vy038/Project_Stride/CAD/GBM2804H_Encoder_Joint_V2/GBM2804H Encoder Joint - Stationary Cap.stl

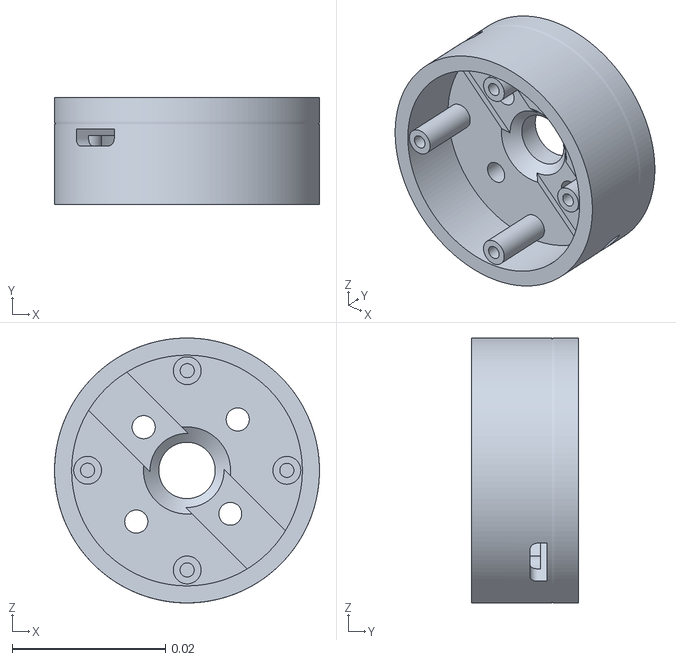
[picture p1: CAD file, 2026-08-30]
CAD/GBM2804H_Encoder_Joint_V2/GBM2804H Encoder Joint - Stationary Cap.stl
0.0346 x 0.014 x 0.0346
