vy038/Project_Stride/CAD/leg/leg - Stand.stl

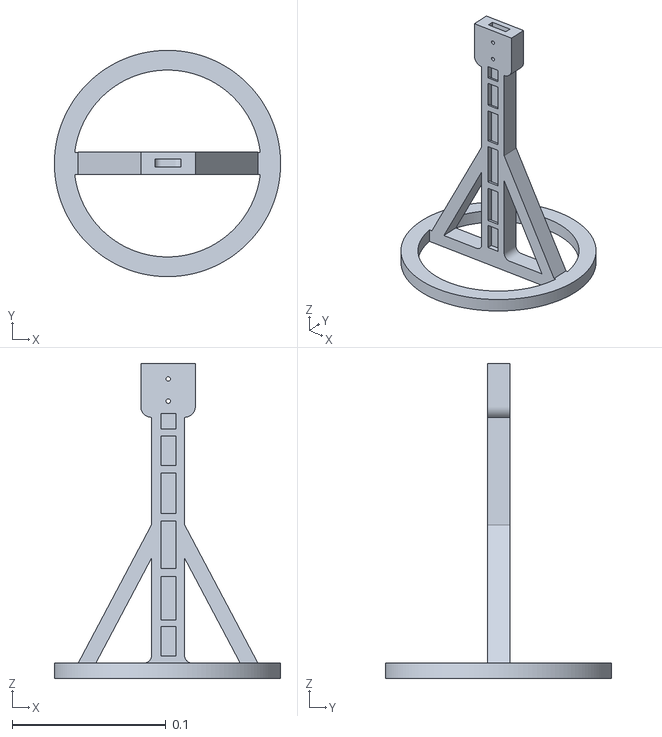
[picture p2: CAD file, 2026-08-30]
CAD/leg/leg - Stand.stl
0.147 x 0.147 x 0.205
