vy038/Project_Stride/CAD/GBM2804H_Encoder_Joint_V2/GBM2804H Encoder Joint - Magnetic Shaft.stl

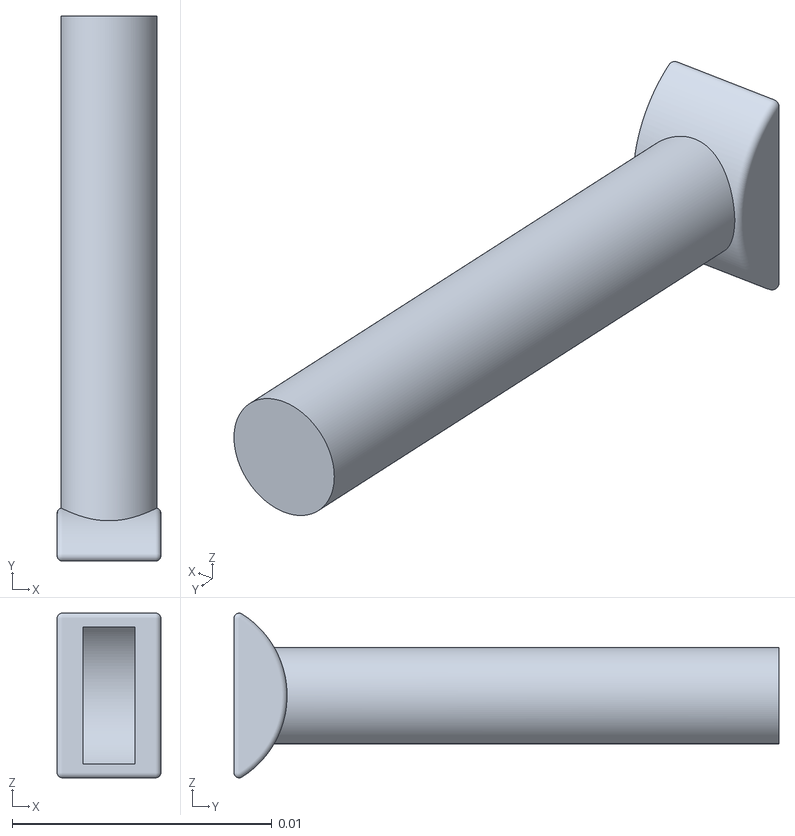
[picture p3: CAD file, 2026-08-30]
CAD/GBM2804H_Encoder_Joint_V2/GBM2804H Encoder Joint - Magnetic Shaft.stl
0.004 x 0.021 x 0.00635
