vy038/Project_Stride/CAD/leg/leg - Encoder Mount on Stationary Cap.stl

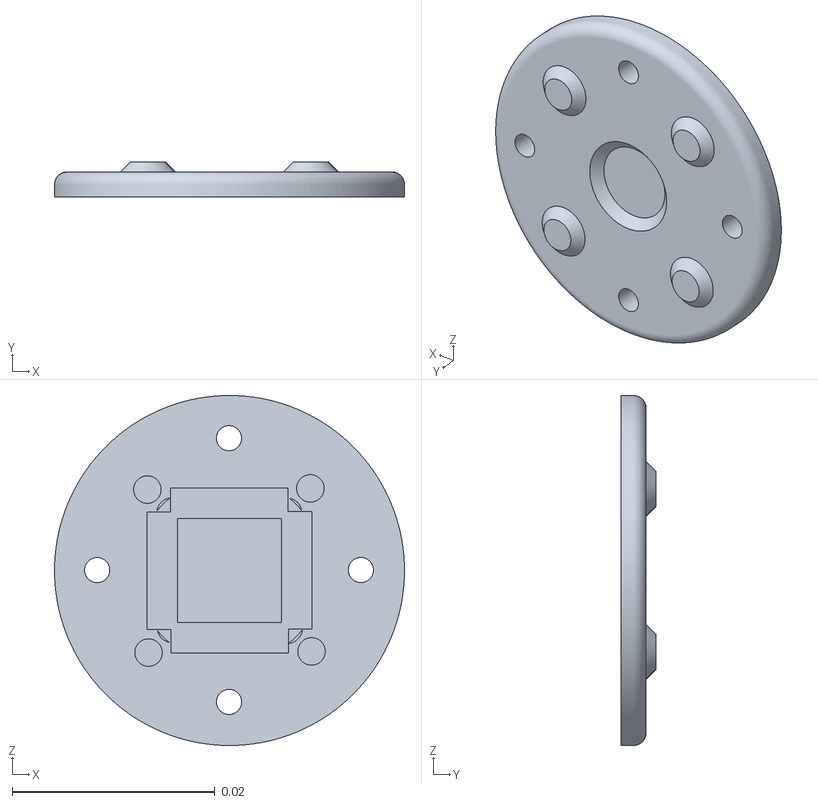
[picture p4: CAD file, 2026-08-30]
CAD/leg/leg - Encoder Mount on Stationary Cap.stl
0.0346 x 0.0035 x 0.0346
