vy038/Project_Stride/CAD/GBM2804H_Encoder_Joint_V2/GBM2804H Encoder Joint - Rotating Cap.stl

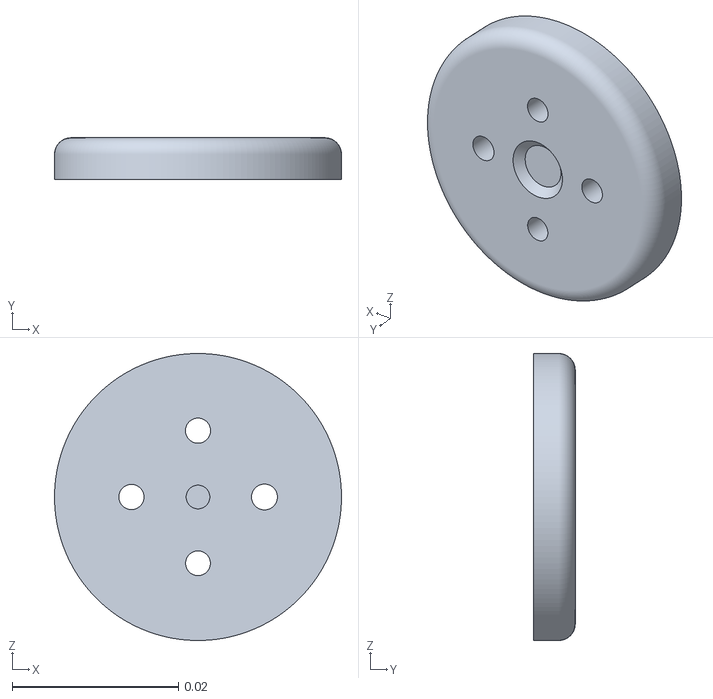
[picture p5: CAD file, 2026-08-30]
CAD/GBM2804H_Encoder_Joint_V2/GBM2804H Encoder Joint - Rotating Cap.stl
0.0346 x 0.005 x 0.0346
