vy038/Project_Stride/CAD/leg/leg - Hip.stl

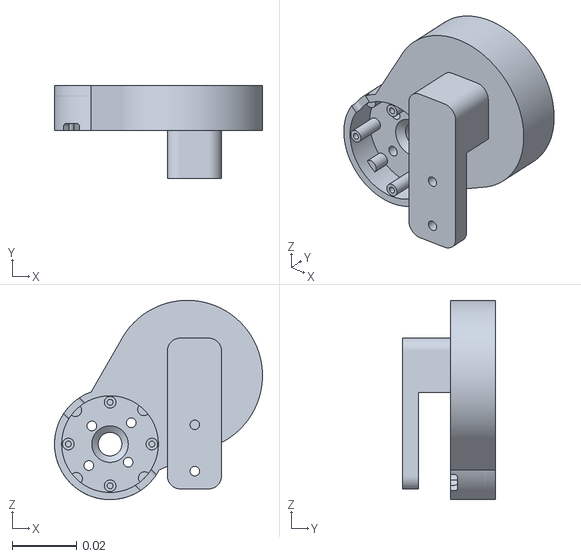
[picture p6: CAD file, 2026-08-30]
CAD/leg/leg - Hip.stl
0.0647 x 0.029 x 0.062
