vy038/Project_Stride/CAD/leg/leg - Tibia.stl

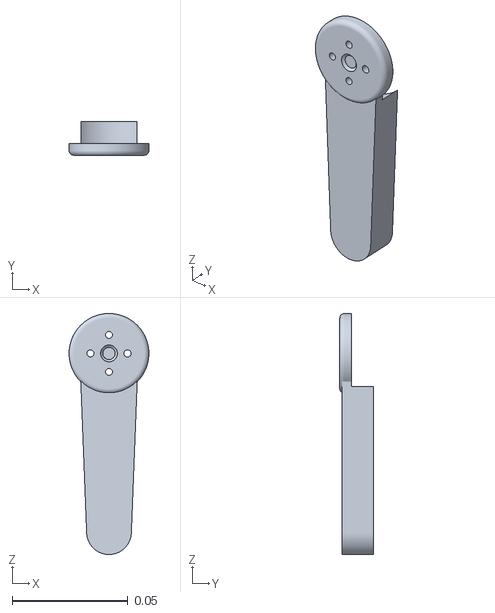
[picture p7: CAD file, 2026-08-30]
CAD/leg/leg - Tibia.stl
0.0346 x 0.0145 x 0.104
