vy038/Project_Stride/CAD/leg/leg - Femur.stl

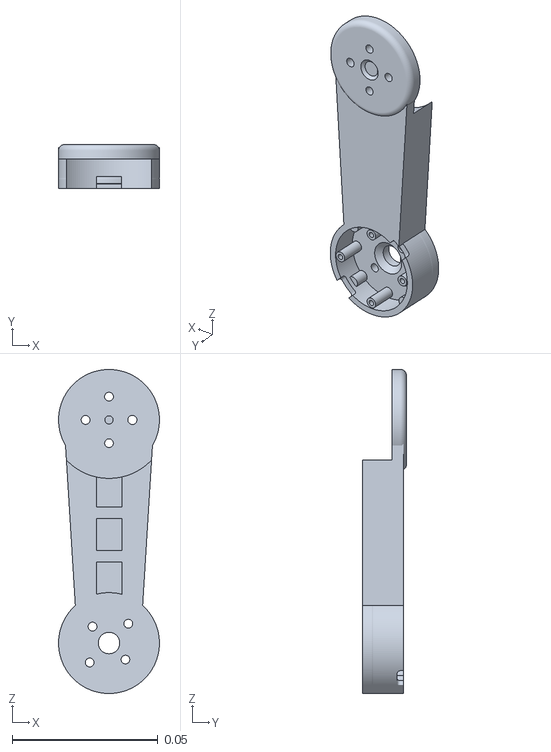
[picture p8: CAD file, 2026-08-30]
CAD/leg/leg - Femur.stl
0.0346 x 0.015 x 0.111
