vy038/Project_Stride/CAD/GBM2804H_Encoder_Joint_V1/Magnetic_Shaft.stl

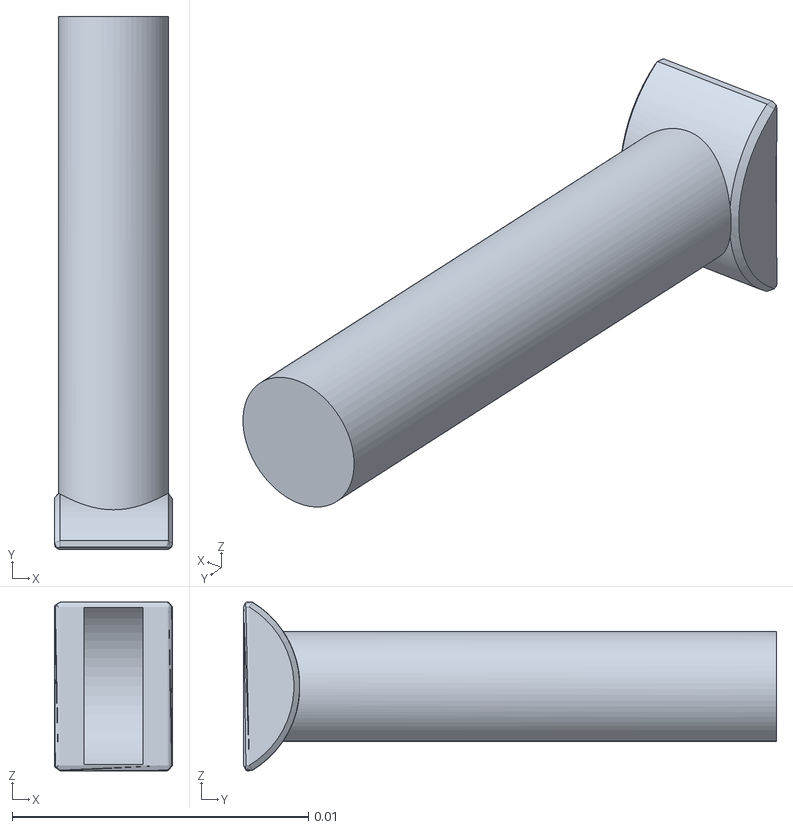
[picture p10: CAD file, 2026-06-14, an earlier design]
CAD/GBM2804H_Encoder_Joint_V1/Magnetic_Shaft.stl
0.004 x 0.018 x 0.00571
