vy038/Project_Stride/CAD/GBM2804H_Encoder_Joint_V1/Magnet.stl

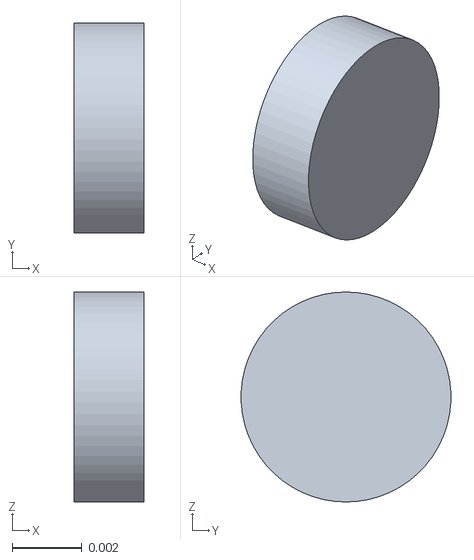
[picture p12: CAD file, 2026-06-14, an earlier design]
CAD/GBM2804H_Encoder_Joint_V1/Magnet.stl
0.002 x 0.006 x 0.006
