vy038/Project_Stride/CAD/GBM2804H_Encoder_Joint_V1/GBM2804H_Motor.stl

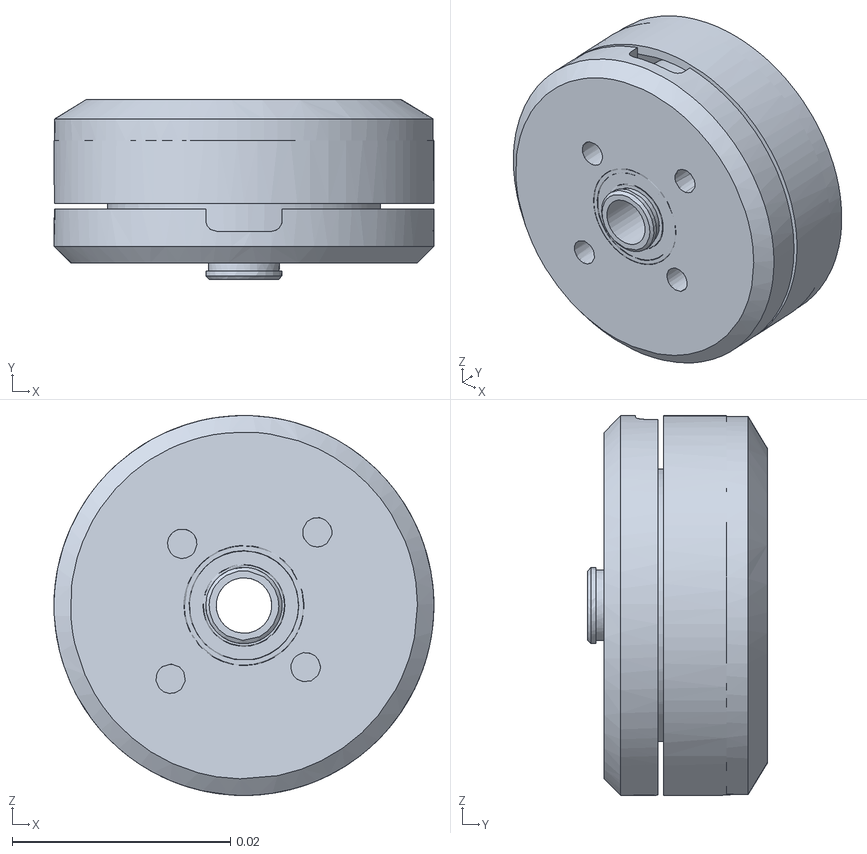
[picture p13: CAD file, 2026-06-14, an earlier design]
CAD/GBM2804H_Encoder_Joint_V1/GBM2804H_Motor.stl
0.0348 x 0.0164 x 0.0348
