vy038/Project_Stride/CAD/GBM2804H_Encoder_Joint_V1/Stationary_Cap.stl

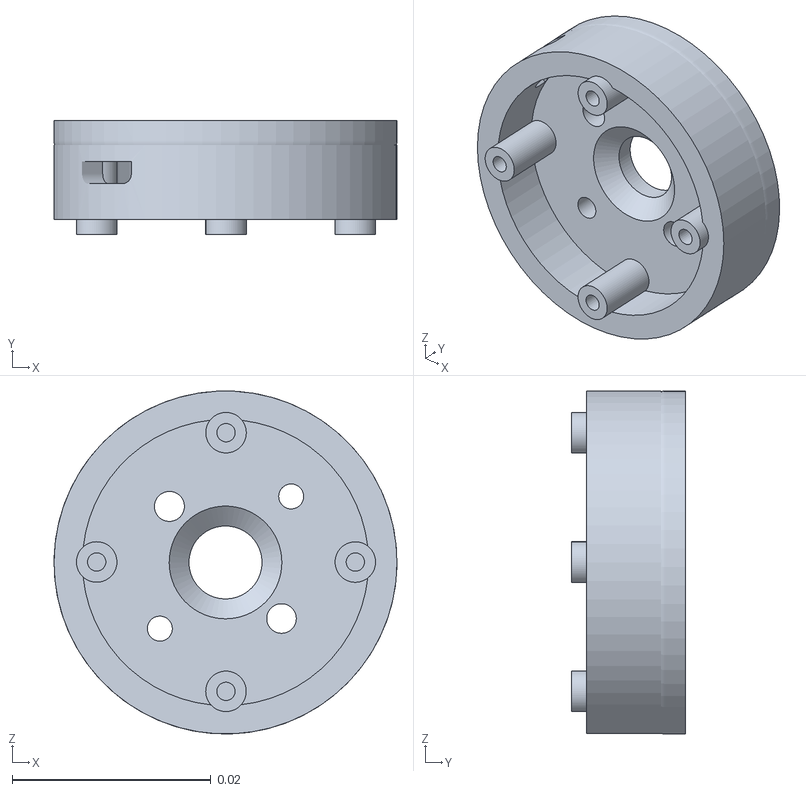
[picture p14: CAD file, 2026-06-14, an earlier design]
CAD/GBM2804H_Encoder_Joint_V1/Stationary_Cap.stl
0.0345 x 0.0115 x 0.0345
