vy038/Project_Stride/(list of files, cad)

Other CAD files:
CAD/GBM2804H_Encoder_Joint_V2/GBM2804H Encoder Joint - Encoder Mount on Stationary Cap.stl
CAD/leg/leg - Encoder Mount on Stationary Cap (1).stl
