vy038/Project_Stride/(commit log)

2026-06-14 feat: add sample encoder joint for GBM2804H
    [GBM2804H Encoder Joint - Encoder Mount on Stationary Cap.stl, GBM2804H Encoder Joint - Magnet.stl, GBM2804H Encoder Joint - Magnetic Shaft.stl, GBM2804H Encoder Joint - Motor.stl, GBM2804H Encoder Joint - Rotating Cap.stl, GBM2804H Encoder Joint - Stationary Cap.stl]
2026-06-14 chore: reorganize and rename files
    [Encoder_Mount_Stationary_Cap.stl, GBM2804H_Motor.stl, Magnet.stl, Magnetic_Shaft.stl, Rotating_Cap.stl, Stationary_Cap.stl]
2026-08-30 feat: add stride leg cad and fixed encoder joints
    [Encoder_Mount_Stationary_Cap.stl, GBM2804H Encoder Joint - Encoder Mount on Stationary Cap.stl, GBM2804H Encoder Joint - Magnetic Shaft.stl, GBM2804H Encoder Joint - Rotating Cap.stl, GBM2804H Encoder Joint - Stationary Cap.stl, GBM2804H_Motor.stl, Magnet.stl, Magnetic_Shaft.stl]
2026-11-07 feat: bringup for uart, debugging
2026-11-07 chore: improve timer documentation
